NPBaoNguyen/Embedded-Systems-Design/README.md

# Embedded-Systems-Design
Design an Air Quality Monitor System
