NPBaoNguyen/Embedded-Systems-Design/block_diagram.drawio.png

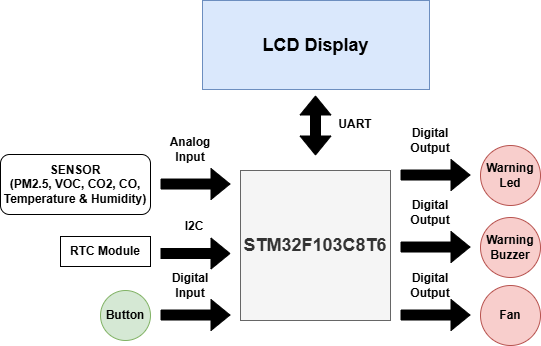
block_diagram.drawio.png
