NPBaoNguyen/Embedded-Systems-Design/HMI-Design/Pictures/1.png

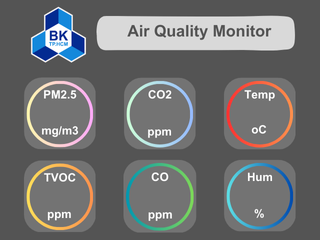
HMI-Design/Pictures/1.png
