NPBaoNguyen/Embedded-Systems-Design/HMI-Design/Pictures/2.png

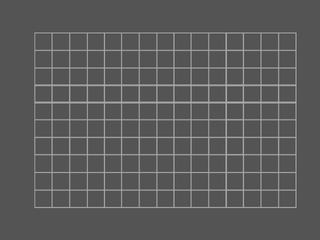
HMI-Design/Pictures/2.png
