NPBaoNguyen/Embedded-Systems-Design/HMI-Design/Pictures/3.png

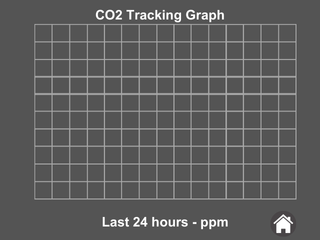
HMI-Design/Pictures/3.png
