NPBaoNguyen/Embedded-Systems-Design/HMI-Design/Pictures/6.png

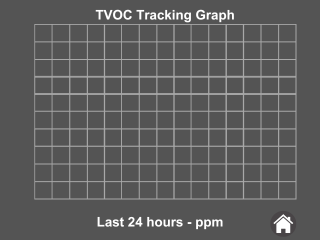
HMI-Design/Pictures/6.png
