NPBaoNguyen/Embedded-Systems-Design/HMI-Design/Pictures/9.png

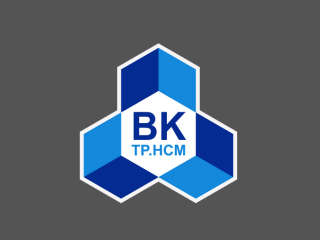
HMI-Design/Pictures/9.png
