NPBaoNguyen/Embedded-Systems-Design/PCB-Design/BTL/BTL.pdf

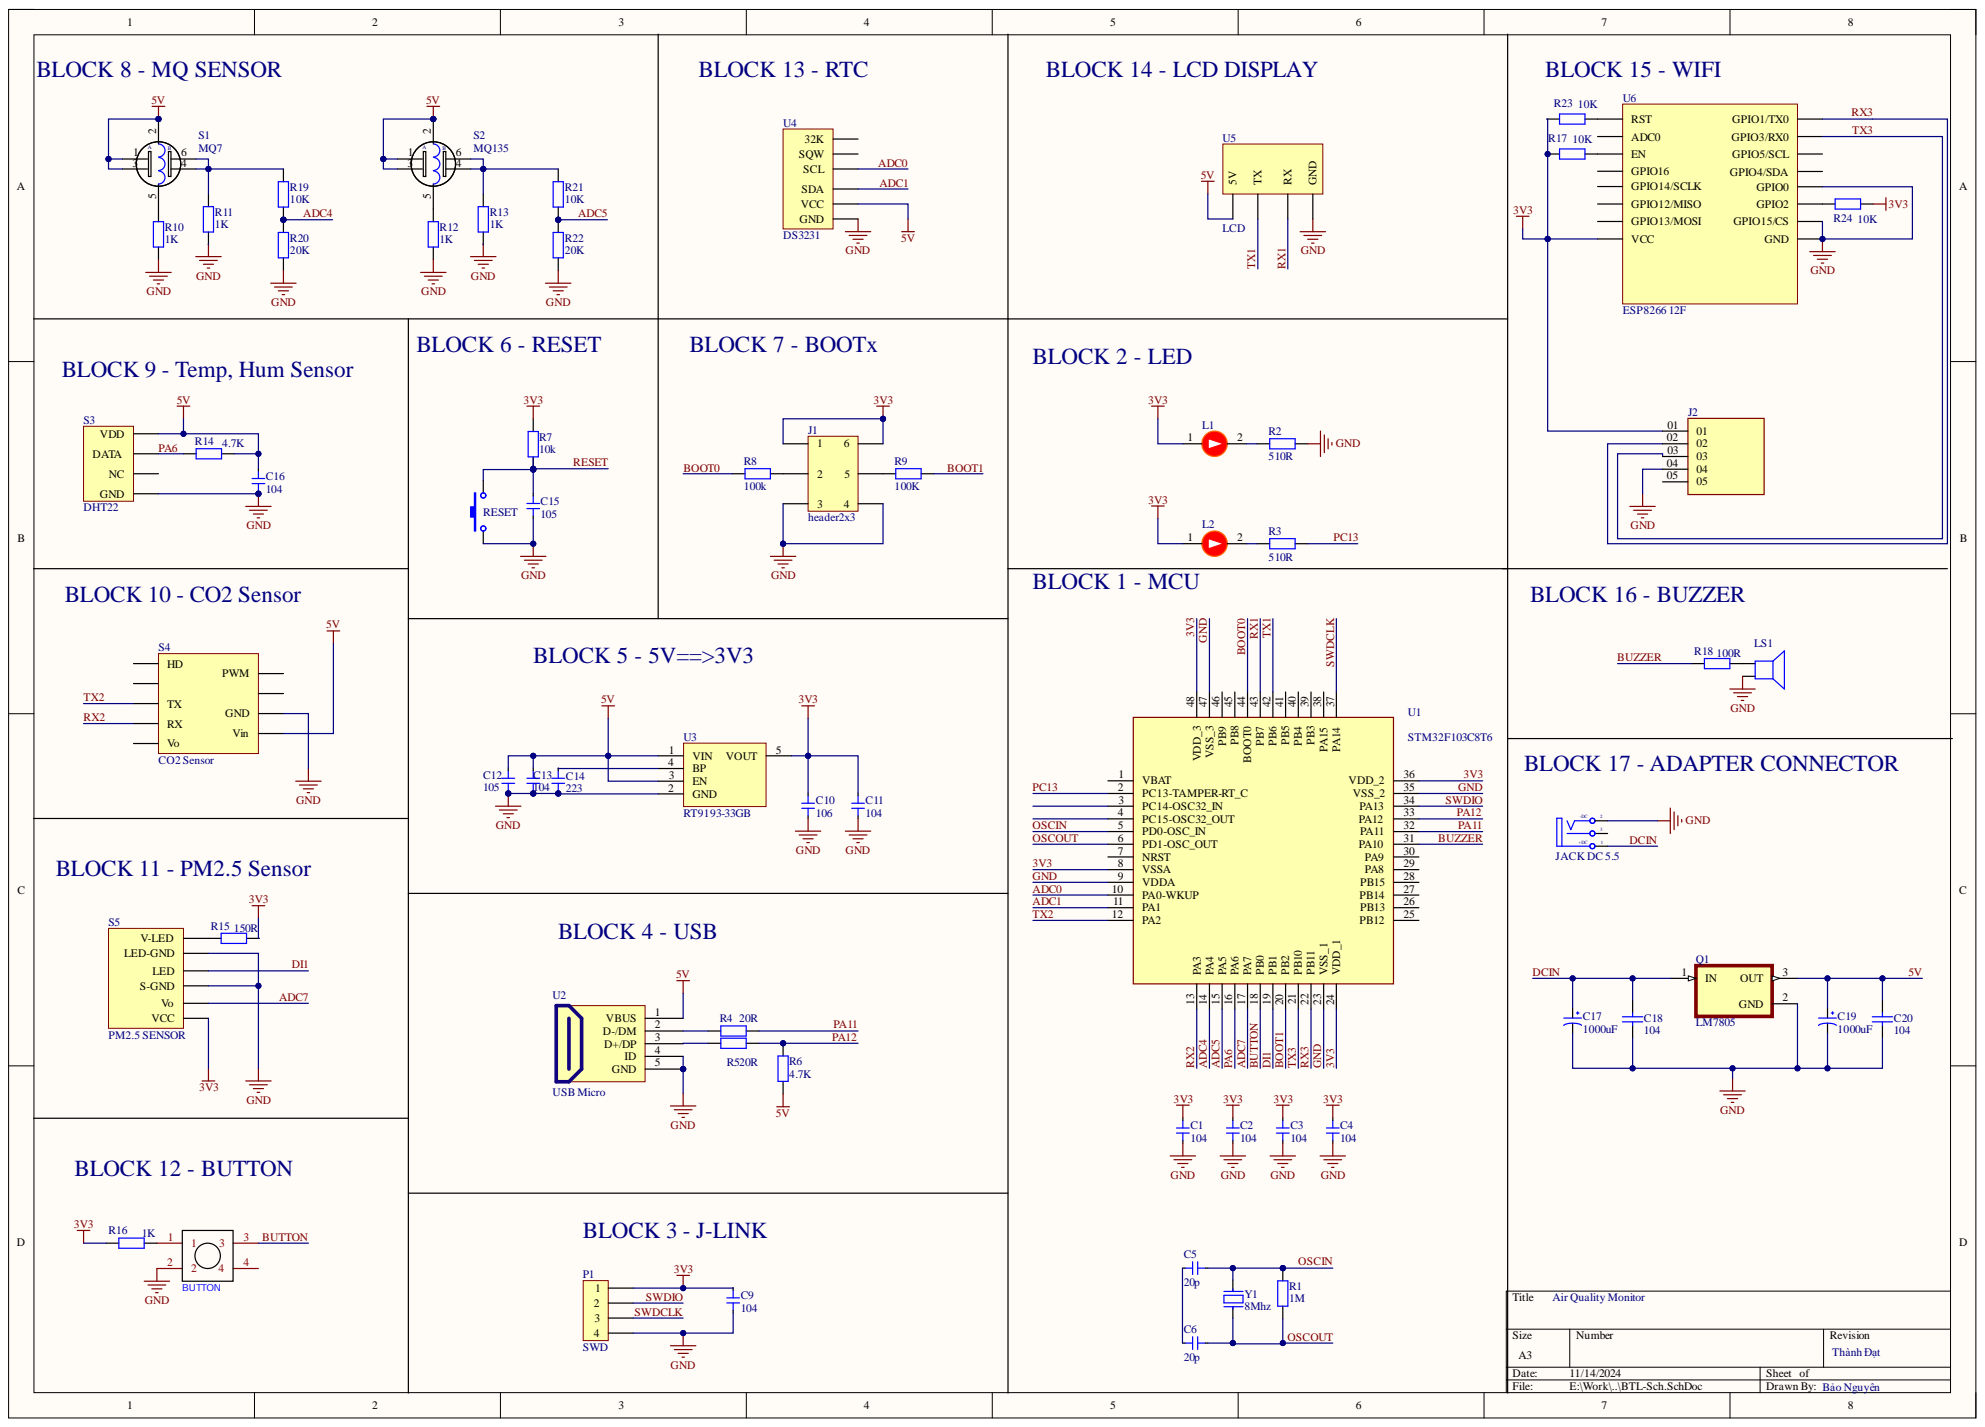
[picture p25: page 1]

BLOCK 9 - Temp, Hum Sensor

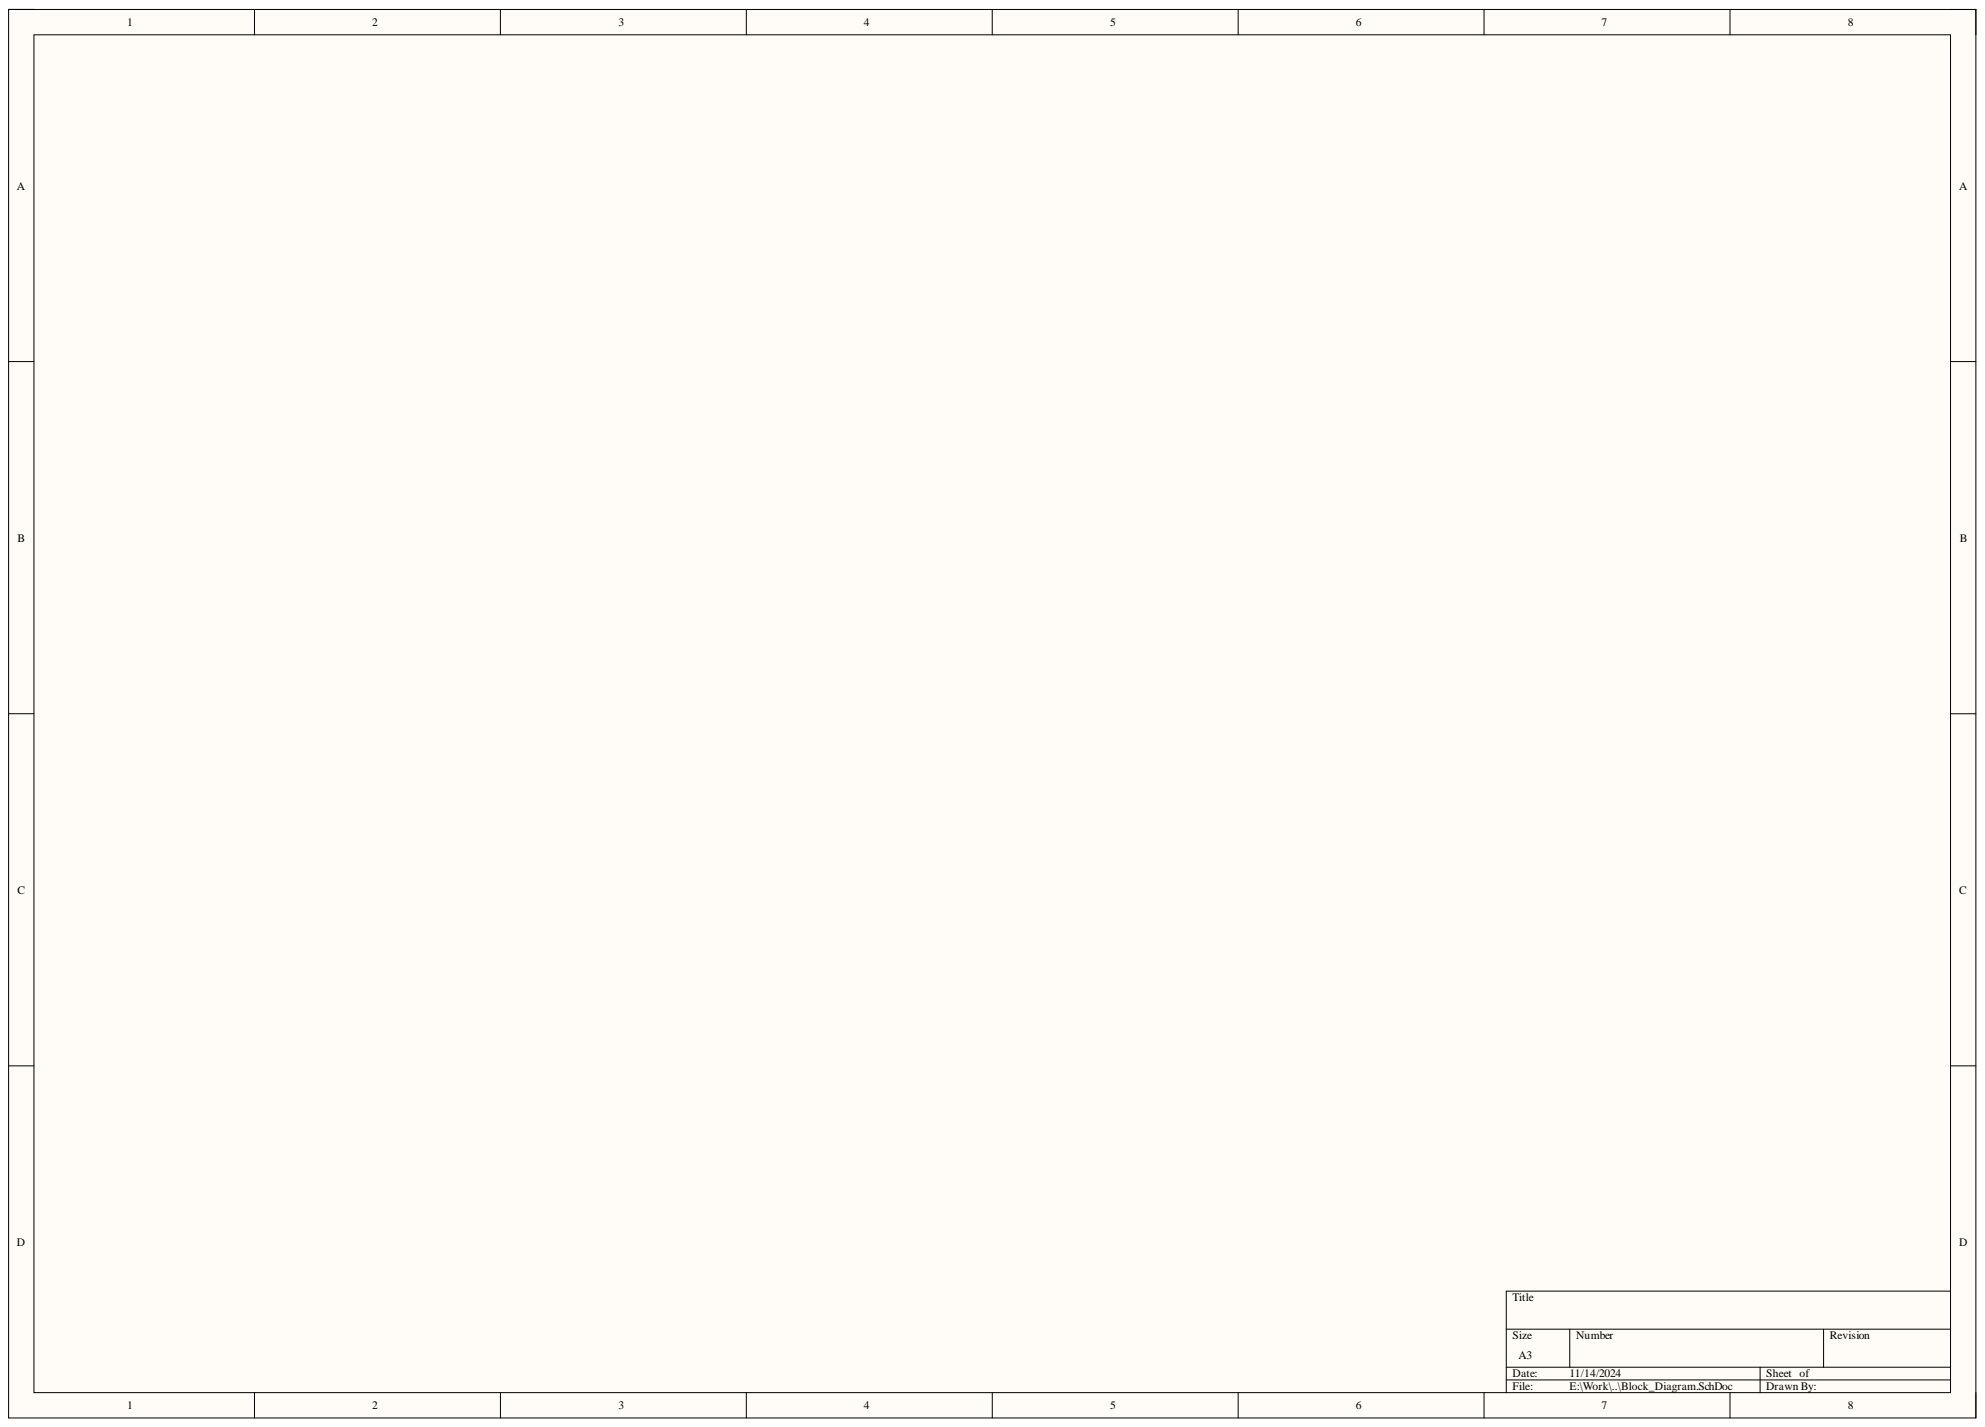
[picture p26: page 2]

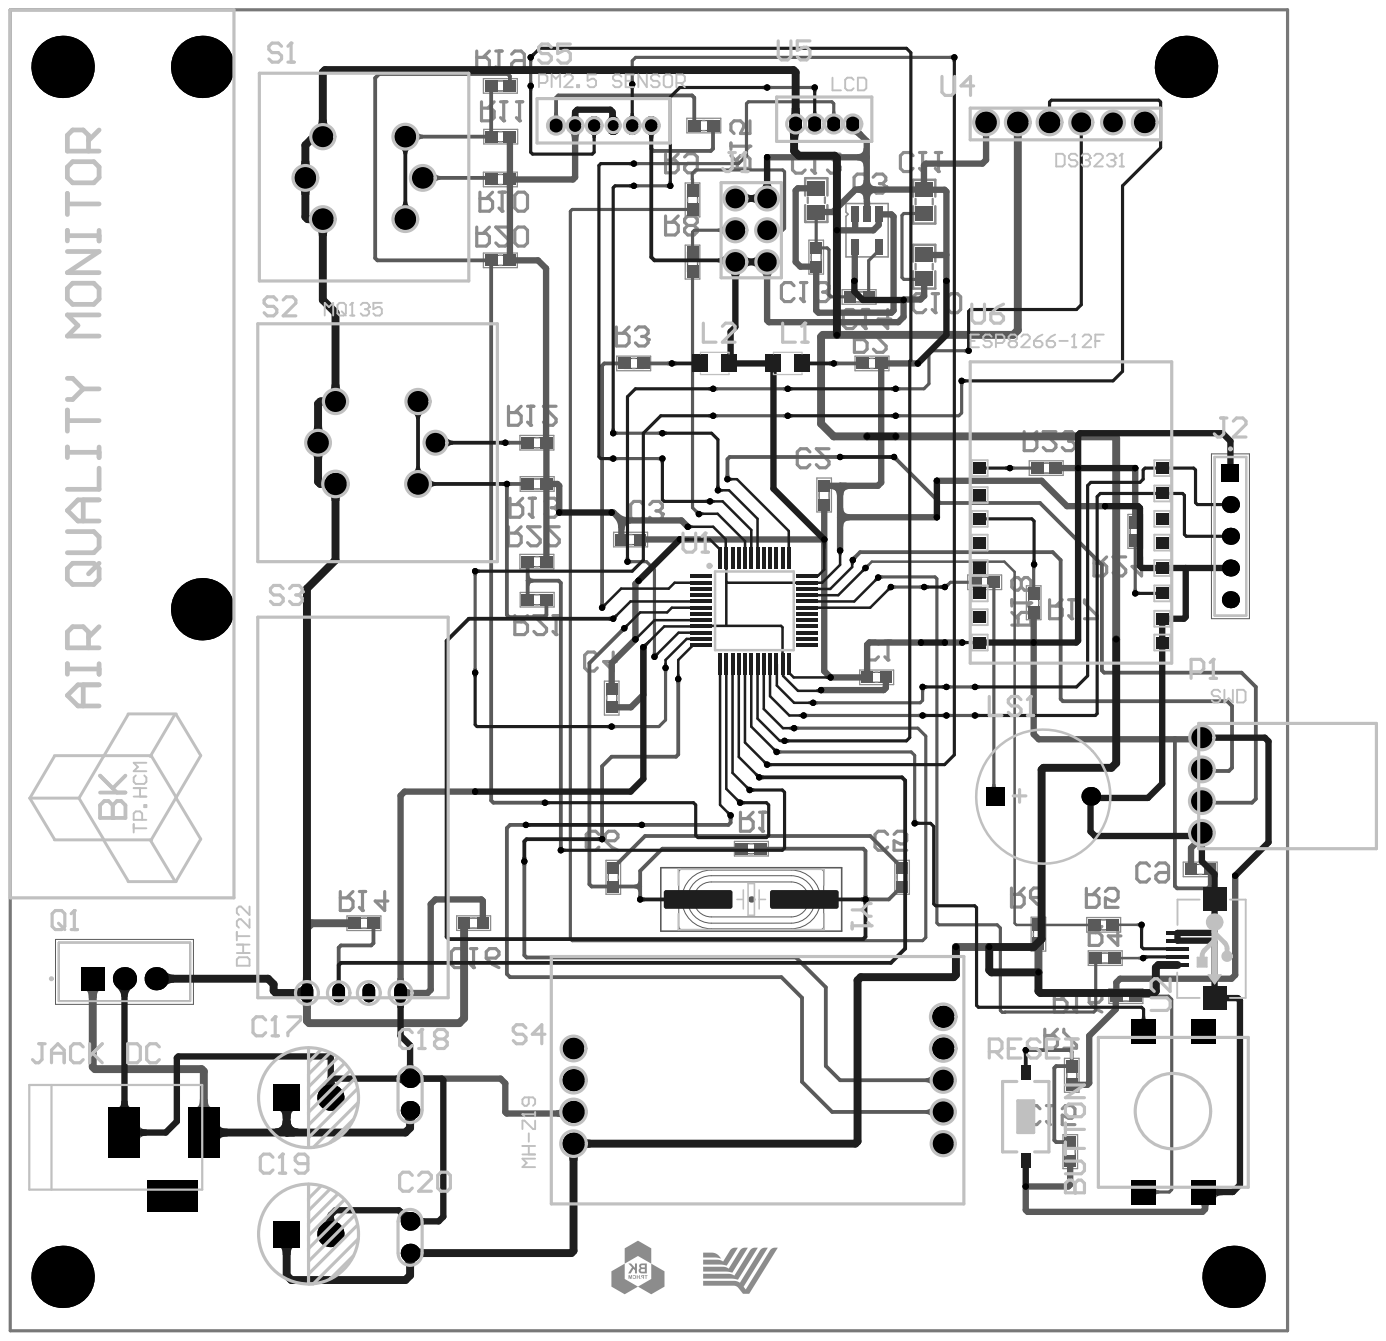
[picture p27: page 3]
