NPBaoNguyen/Embedded-Systems-Design/(list of files, drawings)

Other design files:
PCB-Design/BTL/Block_Diagram.SchDoc
PCB-Design/BTL/BTL-Sch.SchDoc
PCB-Design/BTL/BTL.PrjPcb
