NPBaoNguyen/Embedded-Systems-Design/(commit log)

2024-10-29 Air quality monitor's schematic ver 1,0
2024-11-06 Schematic version 2.0
2024-11-06 BTL Schematic ver 2.0
2024-11-23 Big Update
    [BTL-PCB.GBL, BTL-PCB.GBO, BTL-PCB.GBP, BTL-PCB.GBS, BTL-PCB.GTL, BTL-PCB.GTO, BTL-PCB.GTP, BTL-PCB.GTS]
